AlexZGray/Chipalooza/docs/proposal/README.md

# Proposal versions

- **[Latest simplified proposal — v2](v2/Chipalooza_DAC6_Proposal.md)**: seven digital inputs, three shared analogue lines (VREFH/VREFL/VTAP), one requested dedicated VOUT pad, and one 1 µA bias current.
- **[Original proposal package — v1](v1/README.md)**: the earlier submission draft and provisional equipment attachment. Team details remain placeholders; actual designer CVs are separate attachments.
- **[Current Sky130 implementation and measured results](../../simulations/ltspice/sky130_dac6/docs/Design_Report.md)**: transistor schematics, hand calculations, buffer margin and reproducible verification.

The proposal versions are preserved as drafts. Their simulation sections describe the earlier teaching model. Use the current design report for the subsequent Sky130 results and remaining layout/harness qualification. The shared-reference-switch drop estimated in v2 still needs verification with the organiser's harness model.
