AlexZGray/Chipalooza/docs/proposal/v1/README.md

# Buffered DAC initial proposal

Initial proposal package for **Chipalooza Challenge #4**, prepared on 12 November 2026. **Status: prepared for team review; not submitted.** Specifications are proposed Sky130 development targets, distinct from the verified functional LTspice reference.

## Main technical proposal

- **[Read the proposal PDF](Chipalooza_DAC6_Initial_Proposal.pdf)**
- [Edit the Word document](Chipalooza_DAC6_Initial_Proposal.docx)
- [Browse the proposal text](Chipalooza_DAC6_Initial_Proposal.md)

The main document covers the architecture, I/O and test access, harness resources, minimum/typical/maximum targets, external limits, silicon measurement plan and development milestones. It contains no personal or institutional details.

## Separate equipment attachment

- **[Read the provisional equipment list](Chipalooza_DAC6_Provisional_Equipment.pdf)**
- [Edit the equipment list](Chipalooza_DAC6_Provisional_Equipment.docx)

Equipment and lab access are assumed available for this provisional version. Team name and ICARUS number remain placeholders; specific instrument models and confirmed access have not been invented. Send the completed equipment list separately from the main proposal.

## Review and submission

- [Project suitability and requirements review](Readiness_Review.md)
- [Submission instructions and administrative placeholders](Submission_Details.md)

Fill team/contact details in a private submission copy and attach each designer’s actual CV separately. This public package contains no CVs or filled personal information. The official submission deadline is **23 November 2026**; see the [submission instructions](https://opencircuitdesign.com/chipalooza/get-involved.html).

The proposal plans an EN_MON test output and a nominal 1 µA harness bias interface. These additions are not claimed to exist in the current [LTspice demonstrator](../../simulations/ltspice/dac6/README.md).
