AlexZGray/Chipalooza/simulations/ltspice/dac6/docs/DAC_Bank8.png

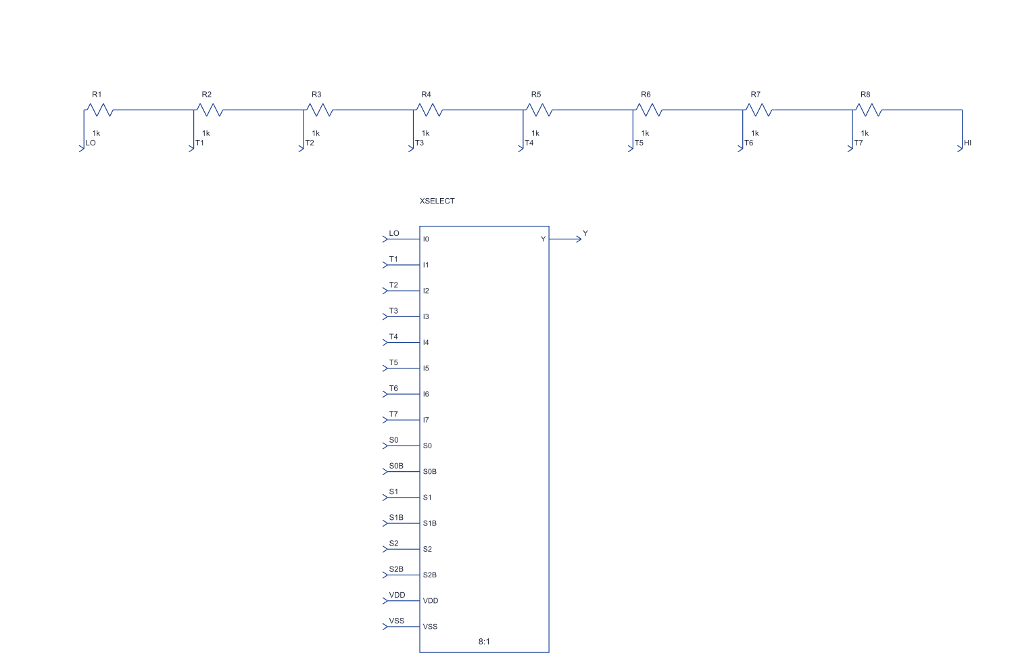
simulations/ltspice/dac6/docs/DAC_Bank8.png
