AlexZGray/Chipalooza/simulations/ltspice/dac6/docs/DAC_Buffer.png

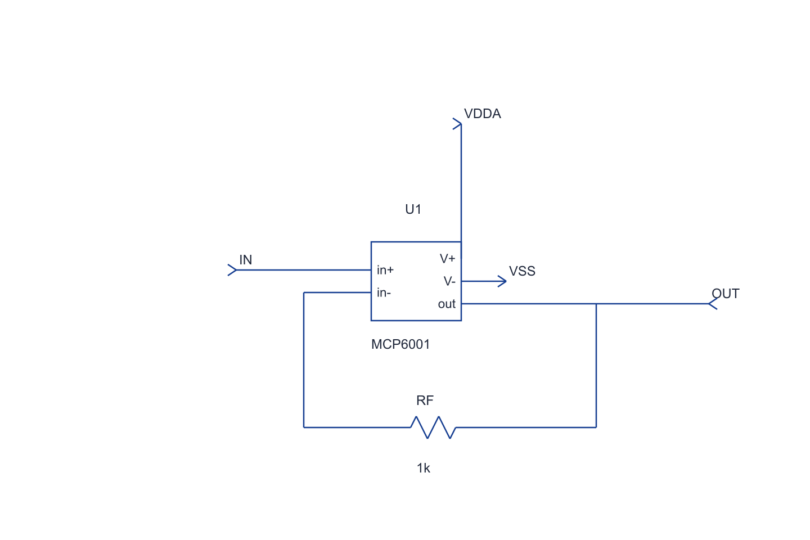
simulations/ltspice/dac6/docs/DAC_Buffer.png
