AlexZGray/Chipalooza/simulations/ltspice/dac6/docs/DAC_LevelShift.png

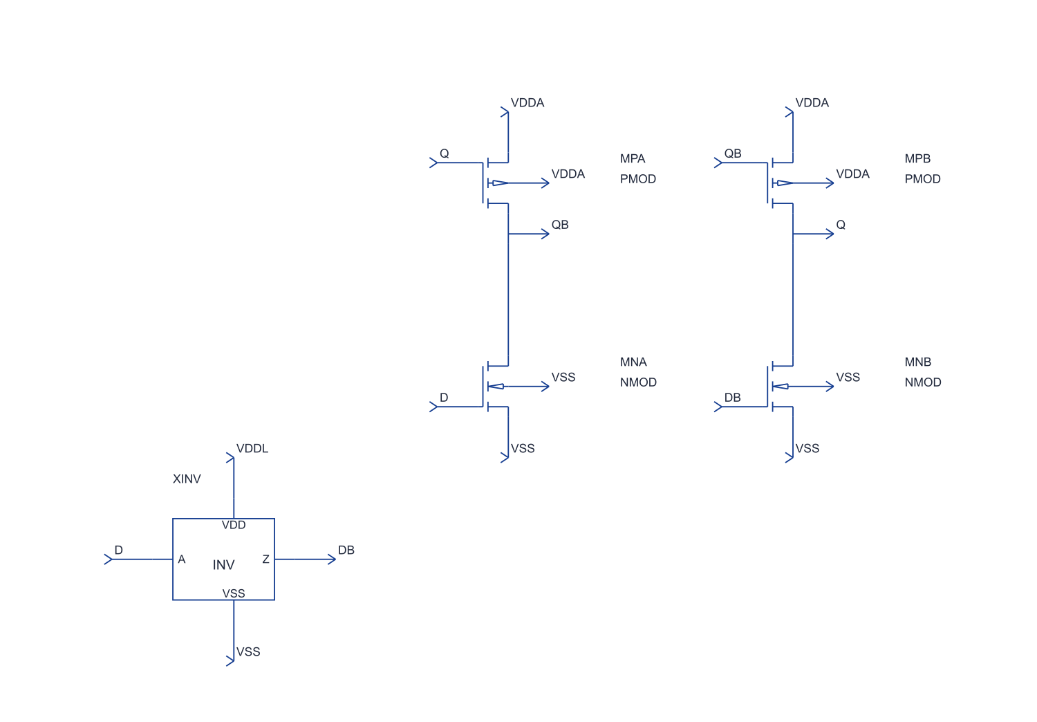
simulations/ltspice/dac6/docs/DAC_LevelShift.png
