AlexZGray/Chipalooza/simulations/ltspice/dac6/docs/DAC_Mux8.png

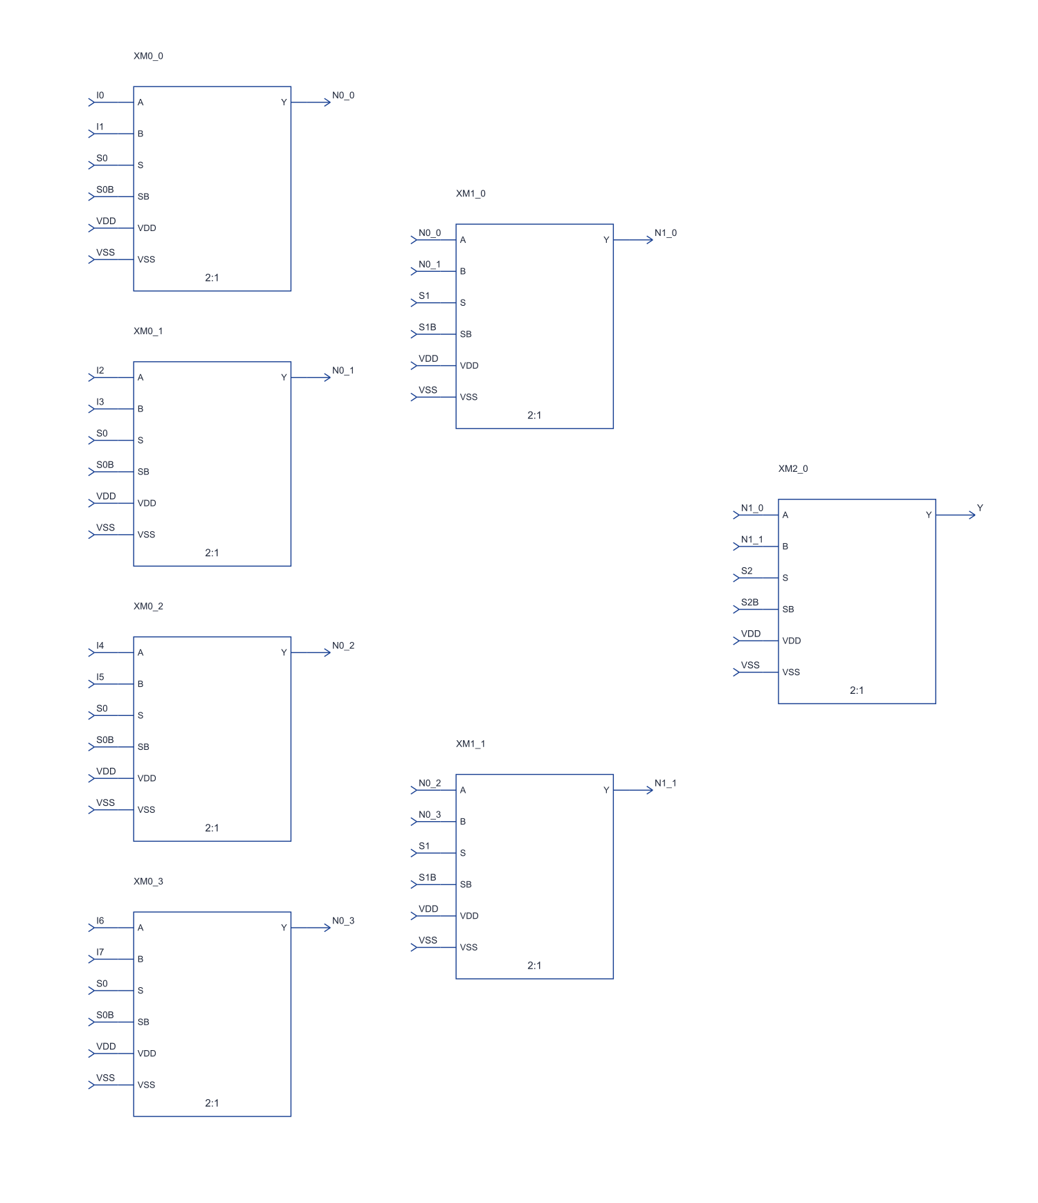
simulations/ltspice/dac6/docs/DAC_Mux8.png
