AlexZGray/Chipalooza/simulations/ltspice/sky130_dac6/docs/Amplifier_Blocks.png

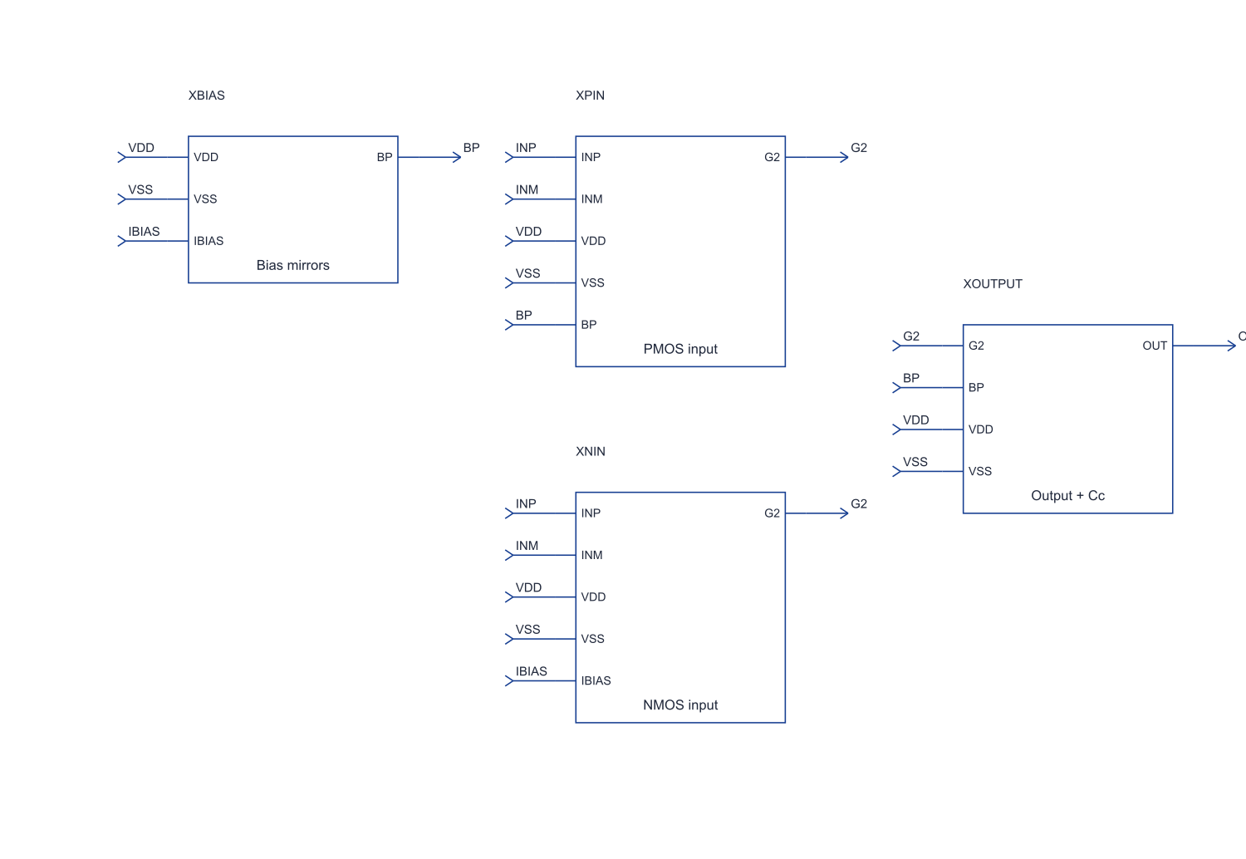
simulations/ltspice/sky130_dac6/docs/Amplifier_Blocks.png
