AlexZGray/Chipalooza/simulations/ltspice/sky130_dac6/docs/Core.png

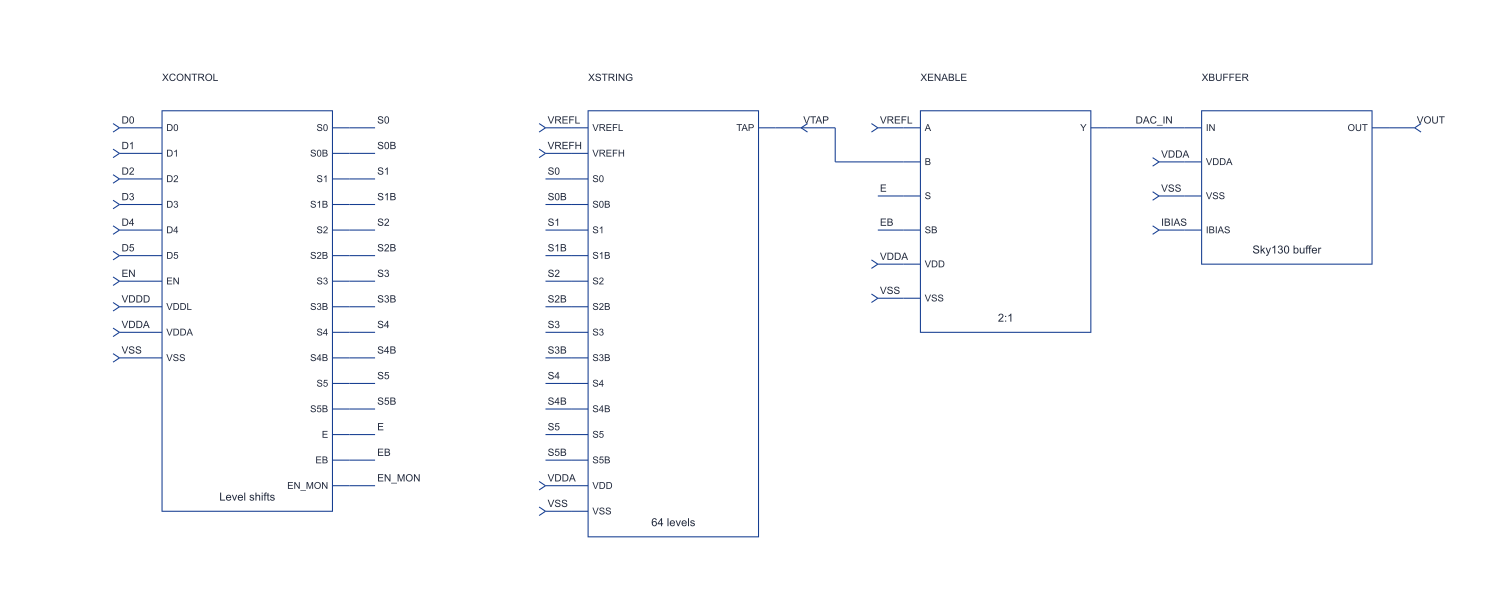
simulations/ltspice/sky130_dac6/docs/Core.png
