AlexZGray/Chipalooza/simulations/ltspice/sky130_dac6/docs/Integration.png

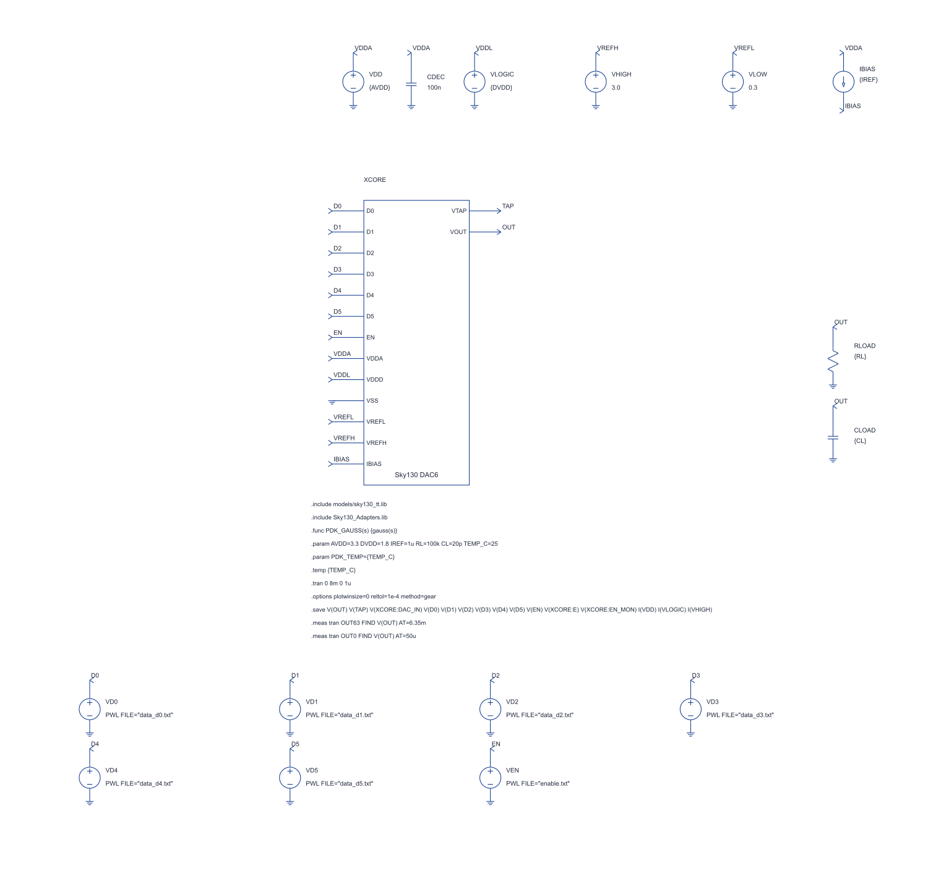
simulations/ltspice/sky130_dac6/docs/Integration.png
