AlexZGray/Chipalooza/simulations/ltspice/sky130_dac6/docs/Output_Stage.png

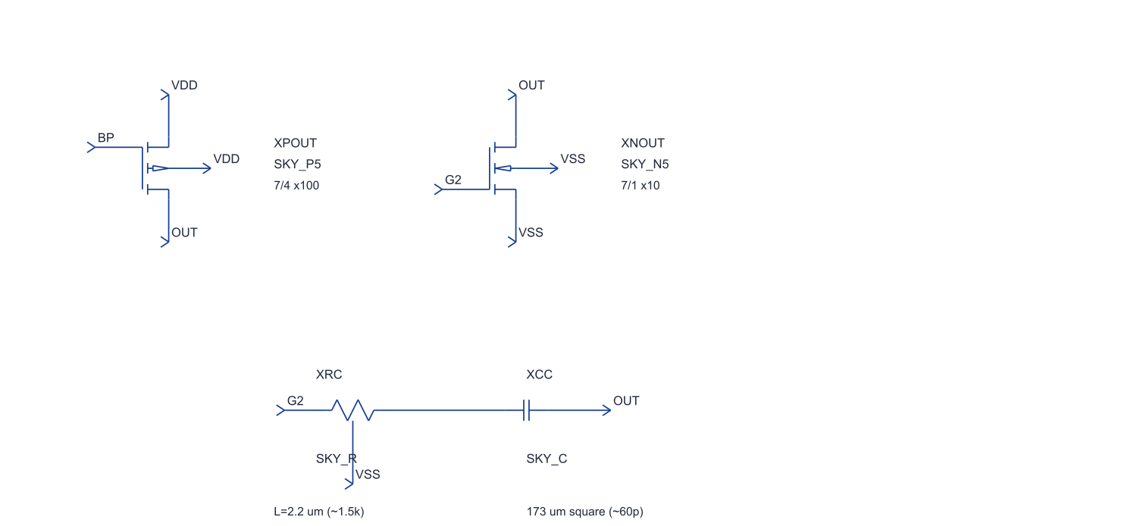
simulations/ltspice/sky130_dac6/docs/Output_Stage.png
