AlexZGray/Chipalooza/simulations/ltspice/dac6/results/reference_all_codes.csv

code | ideal_V | tap_V | output_V | error_LSB
0 | 0.3 | 0.30000001192092896 | 0.2954992651939392 | -0.10668408429181107
1 | 0.3421875 | 0.34218764305114746 | 0.33768680691719055 | -0.10668309529622343
2 | 0.384375 | 0.38437527418136597 | 0.3798743188381195 | -0.10668281272605665
3 | 0.4265625 | 0.4265628755092621 | 0.42206183075904846 | -0.10668253015588856
4 | 0.46875 | 0.4687504768371582 | 0.46424931287765503 | -0.10668295401114004
5 | 0.5109375 | 0.5109380483627319 | 0.5064367651939392 | -0.10668408429181239
6 | 0.5531250000000001 | 0.5531256198883057 | 0.5486242175102234 | -0.10668521457248474
7 | 0.5953125 | 0.5953131914138794 | 0.5908116698265076 | -0.10668634485315445
8 | 0.6375 | 0.6375007033348083 | 0.6329991221427917 | -0.10668747513382418
9 | 0.6796875 | 0.6796882748603821 | 0.6751865744590759 | -0.10668860541449653
10 | 0.721875 | 0.721875786781311 | 0.7173739671707153 | -0.10669114854600799
11 | 0.7640625000000001 | 0.76406329870224 | 0.7595614194869995 | -0.10669227882668034
12 | 0.8062500000000001 | 0.806250810623169 | 0.8017488121986389 | -0.10669482195819181
13 | 0.8484375 | 0.8484383225440979 | 0.8439362049102783 | -0.10669736508969802
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
