AlexZGray/Chipalooza/simulations/ltspice/sky130_dac6/results/reference_Cold_Skew_codes.csv

code | ideal_V | output_V | tap_V | error_LSB
0 | 0.3 | 0.2995744049549103 | 0.3000001013278961 | -0.010088178846570917
1 | 0.3421875 | 0.3417590260505676 | 0.3421894311904907 | -0.010156419542100167
2 | 0.384375 | 0.3839437961578369 | 0.38437861204147333 | -0.010221128110532933
3 | 0.4265625 | 0.42612841725349426 | 0.42656765810342745 | -0.010289368806062184
4 | 0.46875 | 0.4683104543990311 | 0.4687565267086029 | -0.010418858689633822
5 | 0.5109375 | 0.5104536826316917 | 0.5109453797340393 | -0.011468263545087556
6 | 0.5531250000000001 | 0.5526889496349839 | 0.5531342029571533 | -0.010336008652234656
7 | 0.5953125 | 0.5948880314826965 | 0.595322847366333 | -0.010061475965712332
8 | 0.6375 | 0.6370950937271118 | 0.6375113129615784 | -0.009597778320311447
9 | 0.6796875 | 0.6793208122253418 | 0.6796998381614685 | -0.008691858362268517
10 | 0.721875 | 0.7215672731399536 | 0.7218882441520691 | -0.007294266312211701
11 | 0.7640625000000001 | 0.7638219594955443 | 0.7640765309333801 | -0.005701700846358904
12 | 0.8062500000000001 | 0.8060633540153503 | 0.8062647581100465 | -0.004424201117624685
13 | 0.8484375 | 0.8482827544212341 | 0.8484529048503129 | -0.0036680433485232525
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
