AlexZGray/Chipalooza/simulations/ltspice/sky130_dac6/results/reference_Hot_Fast_codes.csv

code | ideal_V | output_V | tap_V | error_LSB
0 | 0.3 | 0.29991474747657776 | 0.2999999225139618 | -0.0020208005551936026
1 | 0.3421875 | 0.3421083390712738 | 0.3421839475631714 | -0.0018764071994352375
2 | 0.384375 | 0.38431042432785034 | 0.38436806201934814 | -0.0015306825991035355
3 | 0.4265625 | 0.42652127146720886 | 0.42655226588249207 | -0.0009772689254198233
4 | 0.46875 | 0.4687393836271575 | 0.46873652935028076 | -0.00025164735626661796
5 | 0.5109375 | 0.5109602212905884 | 0.5109208226203918 | 0.0005385787398716324
6 | 0.5531250000000001 | 0.5531772375106812 | 0.5531052350997925 | 0.0012382224754029871
7 | 0.5953125 | 0.5953848361968994 | 0.5952897625047097 | 0.001714635778355955
8 | 0.6375 | 0.637581467628479 | 0.6374742984771729 | 0.0019310845269107748
9 | 0.6796875 | 0.6797692775726318 | 0.6796588897705078 | 0.001938431351273148
10 | 0.721875 | 0.7219520211219788 | 0.7218436598777771 | 0.00182568585431029
11 | 0.7640625000000001 | 0.7641326189041138 | 0.7640284299850464 | 0.0016620777271390984
12 | 0.8062500000000001 | 0.8063130378723145 | 0.8062133193016052 | 0.0014942310474505456
13 | 0.8484375 | 0.848493754863739 | 0.8483982682228088 | 0.001333448621962858
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
