AlexZGray/Chipalooza/simulations/ltspice/sky130_dac6/results/reference_Integration_codes.csv

code | ideal_V | output_V | tap_V | error_LSB
0 | 0.3 | 0.3002528250217438 | 0.3000001311302185 | 0.005992889404297138
1 | 0.3421875 | 0.34243083000183105 | 0.34218934178352356 | 0.005767822265625526
2 | 0.384375 | 0.38460875604736317 | 0.3843783736228943 | 0.0055408840856448665
3 | 0.4265625 | 0.4268085835043205 | 0.42656734585762024 | 0.005833090472781802
4 | 0.46875 | 0.4690018892288208 | 0.4687561094760895 | 0.0059707076461226844
5 | 0.5109375 | 0.511196021252715 | 0.5109449028968811 | 0.006127911175465993
6 | 0.5531250000000001 | 0.5533955693244934 | 0.553133487701416 | 0.006413495099100904
7 | 0.5953125 | 0.5956011414527893 | 0.5953220129013062 | 0.006841871473523779
8 | 0.6375 | 0.6378101110458374 | 0.6375104188919067 | 0.007350780345776515
9 | 0.6796875 | 0.6800147294998169 | 0.6796988248825073 | 0.007756551106770833
10 | 0.721875 | 0.7222056984901428 | 0.7218871116638184 | 0.007838779025606585
11 | 0.7640625000000001 | 0.7643815279006958 | 0.7640753388404846 | 0.007562142831305765
12 | 0.8062500000000001 | 0.8065493702888489 | 0.8062634468078613 | 0.007096184624562814
13 | 0.8484375 | 0.8487175703048706 | 0.8484514951705933 | 0.0066387035228598484
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
