AlexZGray/Chipalooza/simulations/ltspice/sky130_dac6/results/reference_Min_Supply_codes.csv

code | ideal_V | output_V | tap_V | error_LSB
0 | 0.3 | 0.3007352650165558 | 0.29999983310699463 | 0.017428504096137415
1 | 0.3421875 | 0.3429214060306549 | 0.3421834707260132 | 0.017396291097005735
2 | 0.384375 | 0.385111927986145 | 0.38436722755432123 | 0.017467922634548085
3 | 0.4265625 | 0.42730626463890076 | 0.42655104398727417 | 0.017629976625795452
4 | 0.46875 | 0.46950259804725647 | 0.468735009431839 | 0.017839361120153354
5 | 0.5109375 | 0.5116963386535645 | 0.5109189748764038 | 0.017987286603008204
6 | 0.5531250000000001 | 0.5538809895515442 | 0.5531030893325806 | 0.0179197523328972
7 | 0.5953125 | 0.5960503816604614 | 0.5952872037887573 | 0.01749052824797401
8 | 0.6375 | 0.6382039785385132 | 0.6374715566635132 | 0.016686898690683922
9 | 0.6796875 | 0.6803474426269531 | 0.6796558499336243 | 0.01564308449074074
10 | 0.721875 | 0.7224897742271423 | 0.7218402624130249 | 0.01457242612485427
11 | 0.7640625000000001 | 0.7646377086639404 | 0.7640247624450953 | 0.013634575737845116
12 | 0.8062500000000001 | 0.8067945241928101 | 0.8062094449996948 | 0.012907240125864897
13 | 0.8484375 | 0.8489595651626587 | 0.8483941555023193 | 0.012374877929688551
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
