AlexZGray/Chipalooza/simulations/ltspice/sky130_dac6/results/reference_Tap_Probe_codes.csv

code | ideal_V | output_V | tap_V | error_LSB
0 | 0.3 | 0.3002388477325439 | 0.2999861538410187 | 0.005661575882522095
1 | 0.3421875 | 0.3423810303211212 | 0.34213951230049133 | 0.0045873853895404566
2 | 0.384375 | 0.3845158847865515 | 0.3842855393886566 | 0.003339491236776258
3 | 0.4265625 | 0.42666589194026916 | 0.42642468214035034 | 0.0024507719174909283
4 | 0.46875 | 0.4688030183315277 | 0.46855729818344116 | 0.0012567308213975693
5 | 0.5109375 | 0.5109350085258484 | 0.5106838941574097 | -5.905716507628413e-05
6 | 0.5531250000000001 | 0.5530666708946228 | 0.552804708480835 | -0.0013826158311652996
7 | 0.5953125 | 0.5951991677284241 | 0.59492027759552 | -0.0026863945855039985
8 | 0.6375 | 0.6373302936553955 | 0.637030839920044 | -0.004022668909142465
9 | 0.6796875 | 0.6794527769088745 | 0.6791369915008545 | -0.005563806604456018
10 | 0.721875 | 0.7215576171875 | 0.7212389707565308 | -0.007523148148149201
11 | 0.7640625000000001 | 0.7636436820030212 | 0.7633371949195862 | -0.009927537706165298
12 | 0.8062500000000001 | 0.8057183027267456 | 0.8054319620132446 | -0.012603194625292509
13 | 0.8484375 | 0.8477903008460997 | 0.8475238680839539 | -0.015341016981338383
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
