AlexZGray/Chipalooza/simulations/ltspice/sky130_dac6/Buffer_AC.asc

CL: cap; {CLOAD}
IB: current; {IREF}
RL: res; {RLOAD}
VDD: voltage; {AVDD}
VIN: voltage; 1.65
VTEST: voltage; 0 AC 1
XBUF: Sky_OTA
Named nets: VIN, VDD, 0, IBIAS, FB, OUT
.include models/sky130_tt.lib
.include Sky130_Adapters.lib
.func PDK_GAUSS(s) {gauss(s)}
.param AVDD=3.3 IREF=1u RLOAD=100k CLOAD=20p TEMP_C=25
.param PDK_TEMP={TEMP_C}
.temp {TEMP_C}
.ac dec 80 1 100Meg
.options solver=alt plotwinsize=0 reltol=1e-4 abstol=1e-14 vntol=1e-7 gmin=1e-14 itl1=500 itl2=500
.save V(VIN) V(OUT) V(FB) I(VDD)
