AlexZGray/Chipalooza/simulations/ltspice/sky130_dac6/CMOS_INV.asc

XN: nmos4; SKY_N1; w=1 l=0.15 mult=1
XP: pmos4; SKY_P1; w=1 l=0.15 mult=2
Named nets: Z, A, VDD, VSS
