AlexZGray/Chipalooza/simulations/ltspice/sky130_dac6/CMOS_TG.asc

XN: nmos4; SKY_N5; w=7 l=0.5 mult=4
XP: pmos4; SKY_P5; w=7 l=0.5 mult=8
Named nets: EN, VSS, ENB, VDD, IN, OUT
