AlexZGray/Chipalooza/simulations/ltspice/sky130_dac6/DAC6_Sky130_Core.asc

XBUFFER: DAC_Buffer
XCONTROL: DAC_Control
XENABLE: DAC_Mux2
XSTRING: DAC_String64
Named nets: D0, D1, D2, D3, D4, D5, EN, VDDD, VDDA, VSS, S0, S0B, S1, S1B, S2, S2B, S3, S3B, S4, S4B, S5, S5B, E, EB, VREFL, VREFH, VOUT, VTAP, DAC_IN, IBIAS, EN_MON
