AlexZGray/Chipalooza/simulations/ltspice/sky130_dac6/DAC6_Sky130_Hot_Fast.asc

CDEC: cap; 100n
CLOAD: cap; {CL}
IBIAS: current; {IREF}
RLOAD: res; {RL}
VD0: voltage; PWL FILE="stimulus/1p89/data_d0.txt"
VD1: voltage; PWL FILE="stimulus/1p89/data_d1.txt"
VD2: voltage; PWL FILE="stimulus/1p89/data_d2.txt"
VD3: voltage; PWL FILE="stimulus/1p89/data_d3.txt"
VD4: voltage; PWL FILE="stimulus/1p89/data_d4.txt"
VD5: voltage; PWL FILE="stimulus/1p89/data_d5.txt"
VDD: voltage; {AVDD}
VEN: voltage; PWL FILE="stimulus/1p89/enable.txt"
VHIGH: voltage; 3.0
VLOGIC: voltage; {DVDD}
VLOW: voltage; 0.3
XBUFFER: DAC_Buffer
XCONTROL: DAC_Control
XENABLE: DAC_Mux2
XSTRING: DAC_String64
Named nets: D0, D1, D2, D3, D4, D5, EN, VDDL, VDDA, VSS, S0, S0B, S1, S1B, S2, S2B, S3, S3B, S4, S4B, S5, S5B, E, EB, VREFL, VREFH, 0, OUT, TAP, DAC_IN, IBIAS, EN_MON
.include models/sky130_ff.lib
.include Sky130_Adapters.lib
.func PDK_GAUSS(s) {gauss(s)}
.param AVDD=3.465 DVDD=1.89 IREF=1.2u RL=100k CL=20p TEMP_C=110
.param PDK_TEMP={TEMP_C}
.temp {TEMP_C}
.tran 0 8m 0 1u
.options plotwinsize=0 reltol=1e-4 method=gear
.save V(OUT) V(TAP) V(DAC_IN) V(D0) V(D1) V(D2) V(D3) V(D4) V(D5) V(EN) V(E) V(EN_MON) I(VDD) I(VLOGIC) I(VHIGH)
.meas tran OUT63 FIND V(OUT) AT=6.35m
.meas tran OUT0 FIND V(OUT) AT=50u
