AlexZGray/Chipalooza/simulations/ltspice/sky130_dac6/DAC6_Sky130_Integration.asc

CDEC: cap; 100n
CLOAD: cap; {CL}
IBIAS: current; {IREF}
RLOAD: res; {RL}
VD0: voltage; PWL FILE="data_d0.txt"
VD1: voltage; PWL FILE="data_d1.txt"
VD2: voltage; PWL FILE="data_d2.txt"
VD3: voltage; PWL FILE="data_d3.txt"
VD4: voltage; PWL FILE="data_d4.txt"
VD5: voltage; PWL FILE="data_d5.txt"
VDD: voltage; {AVDD}
VEN: voltage; PWL FILE="enable.txt"
VHIGH: voltage; 3.0
VLOGIC: voltage; {DVDD}
VLOW: voltage; 0.3
XCORE: DAC6_Sky130_Core
Named nets: VDDA, 0, VDDL, VREFH, VREFL, D0, D1, D2, D3, D4, D5, EN, OUT, IBIAS, TAP
.include models/sky130_tt.lib
.include Sky130_Adapters.lib
.func PDK_GAUSS(s) {gauss(s)}
.param AVDD=3.3 DVDD=1.8 IREF=1u RL=100k CL=20p TEMP_C=25
.param PDK_TEMP={TEMP_C}
.temp {TEMP_C}
.tran 0 8m 0 1u
.options plotwinsize=0 reltol=1e-4 method=gear
.save V(OUT) V(TAP) V(XCORE:DAC_IN) V(D0) V(D1) V(D2) V(D3) V(D4) V(D5) V(EN) V(XCORE:E) V(XCORE:EN_MON) I(VDD) I(VLOGIC) I(VHIGH)
.meas tran OUT63 FIND V(OUT) AT=6.35m
.meas tran OUT0 FIND V(OUT) AT=50u
