AlexZGray/Chipalooza/(commit log)

2026-11-12 Add runnable hierarchical 6-bit buffered DAC reference
    Bundle the complete LTspice hierarchy, models, stimuli and plot settings with setup instructions, stage explanations, model attribution, previews and reference measurements. Include portable numerical verification and optional plot regeneration; ignore generated simulation data. Verified all three top-level schematics and waveform checks from the repository folder in LTspice 26.1.1.
    [reference_all_codes.csv]
2026-11-12 Add initial buffered DAC proposal and equipment attachment
    Include the reviewed technical proposal and provisional equipment list in PDF and editable Word formats, with proposal text, requirements review and submission templates. Link the package from the main README and retain placeholders and not-submitted status.
2026-11-13 Implement and verify hierarchical Sky130 resistor-string DAC
    [reference_Cold_Skew_codes.csv, reference_Hot_Fast_codes.csv, reference_Integration_codes.csv, reference_Min_Supply_codes.csv, reference_Tap_Probe_codes.csv, reference_Top_codes.csv, reference_bode.csv, reference_range_envelope.csv]
